medlabprojects/MCB_Motherboard/MCB_1-4_schematic.pdf

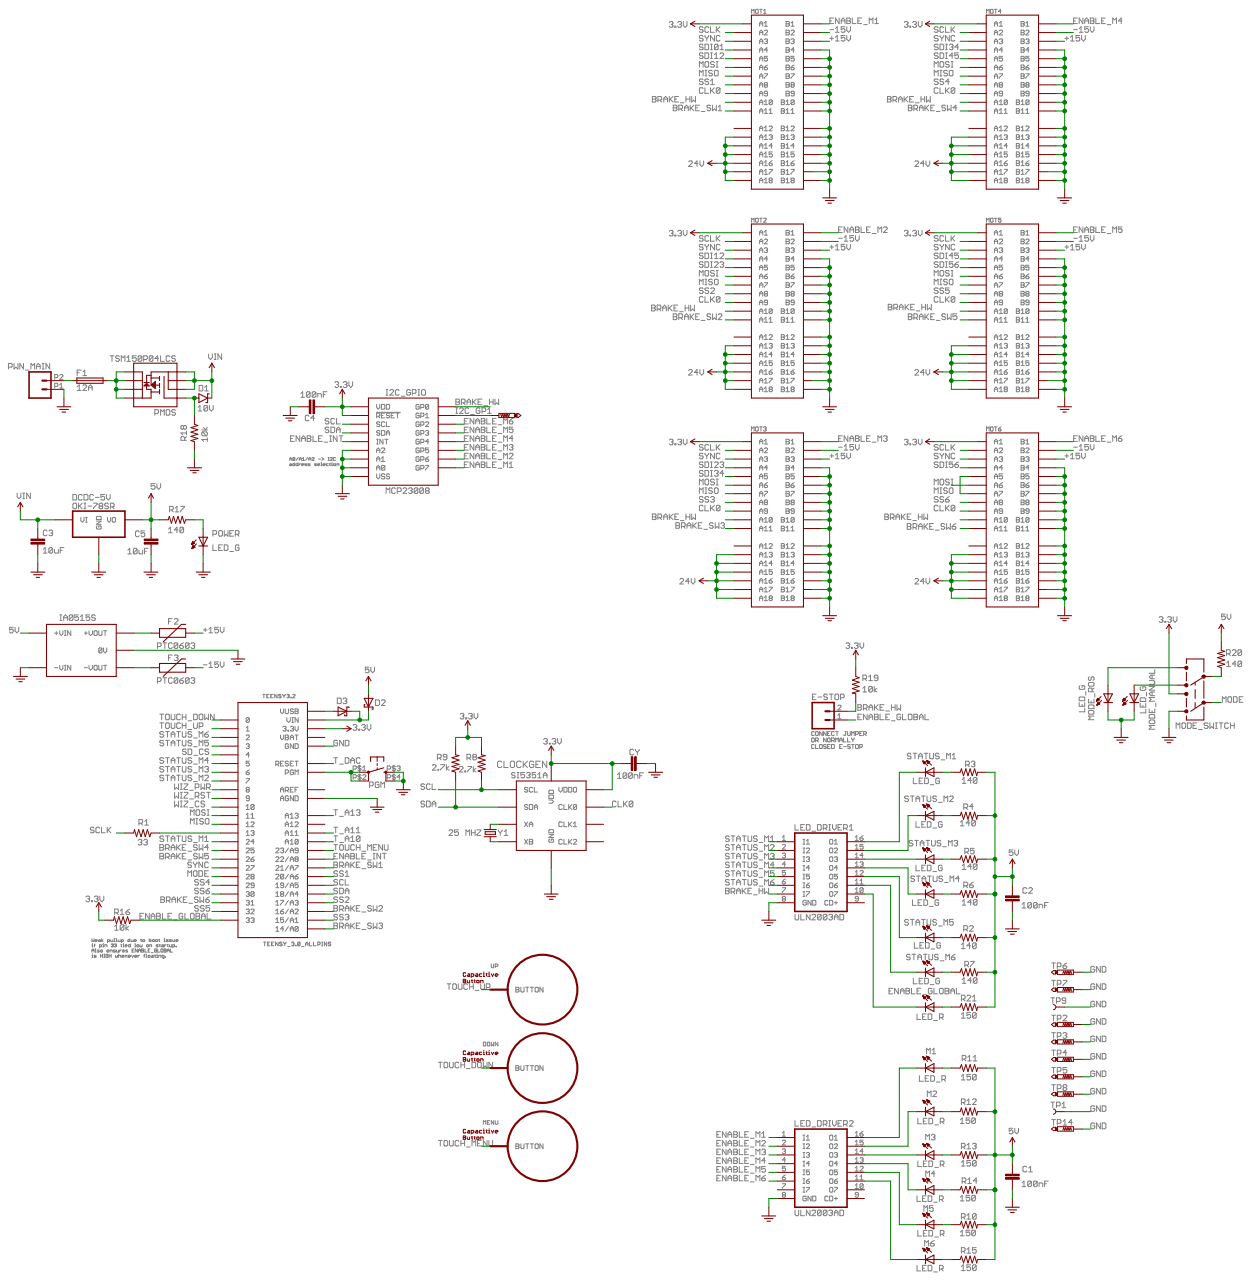
[picture p1: page 1]
