medlabprojects/MCB_Motherboard/Cannula_mother.brd

## EAGLE design Cannula_mother.brd (2018-11-03)

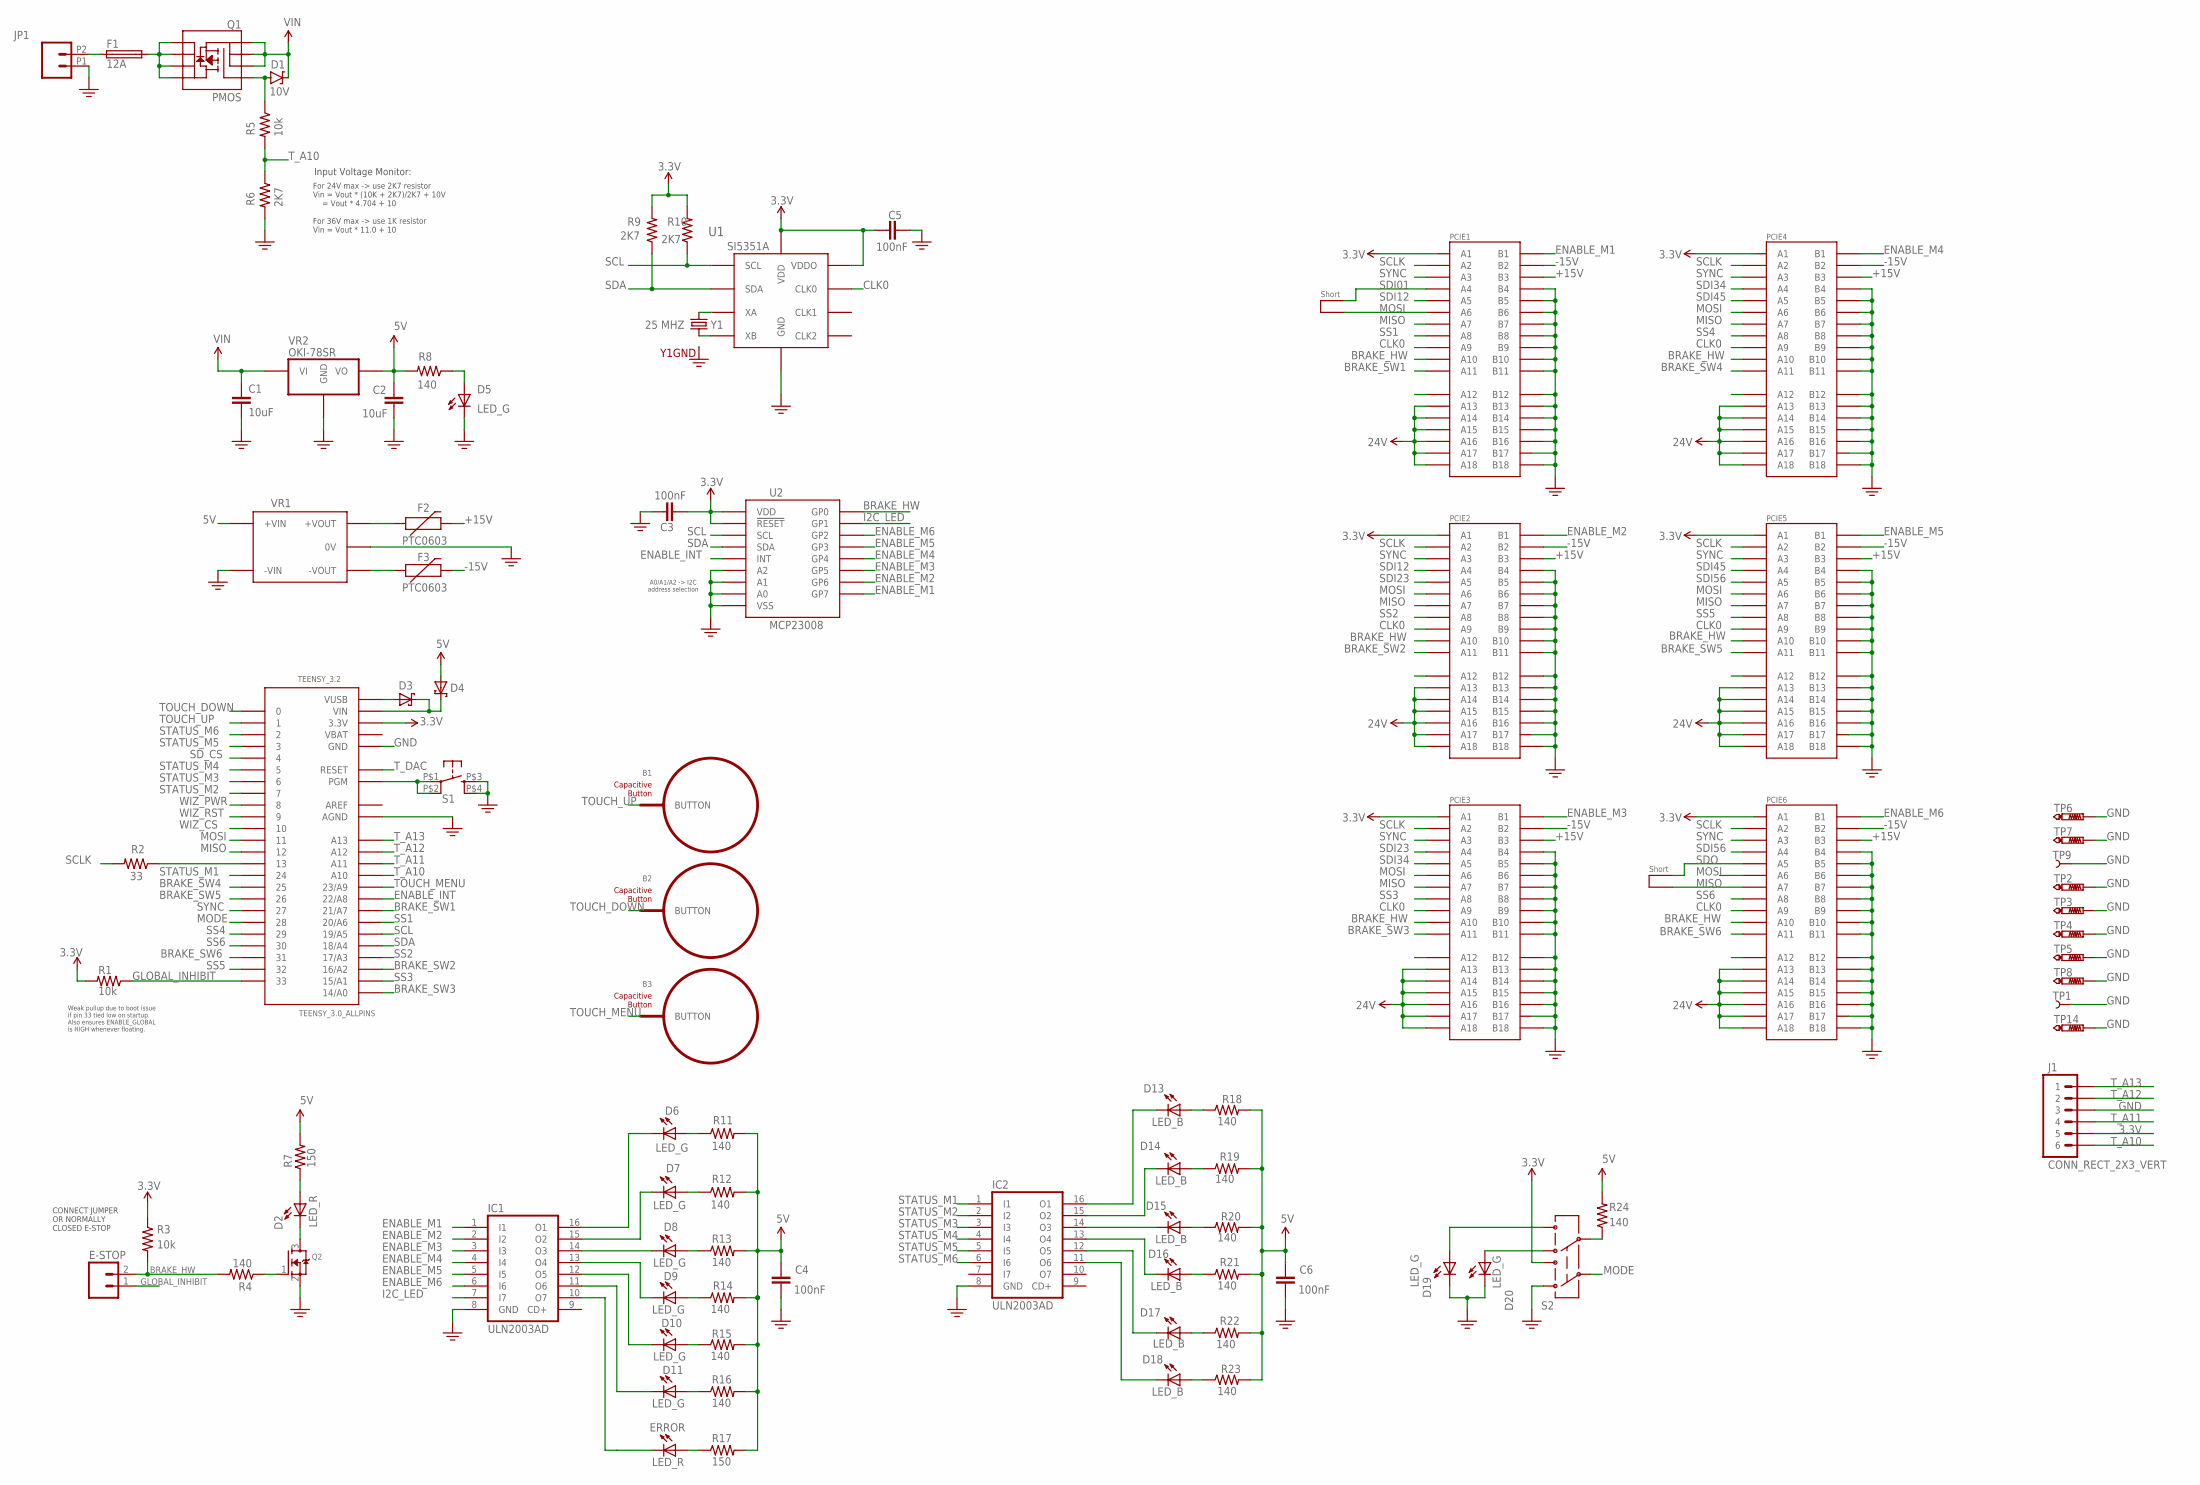
[picture p2: schematic Cannula_mother.sch, Motherboard]

Parts:
B1, B2: BUTTON_PASSIVE-8MM-ARROW; BUTTON_PASSIVE_8MM_UP
B3: BUTTON_PASSIVE-8MM-MENU; BUTTON_PASSIVE_8MM_MENU
C1, C2: 10uF; 1210
C3, C4, C5, C6: 100nF; 0603-CAP
D1: 10V; SOD-323
D2: LED_R; LED-0805
D3, D4: DIODE-POWERDI123; POWERDI123
D5, D6, D7, D8, D9, D10, D11, D19, D20: LED_G; LED-0805
D13, D14, D15, D16, D17, D18: LED_B; LED-0805
E-STOP: M02LOCK; 1X02_LOCK
ERROR: LED_R; LED-0805
F1: 12A; 1206
F2, F3: PTC0603; 0603
IC1, IC2: ULN2003AD; SO16
J1: CONN_RECT_2X3_VERT; 2X3
JP1: M026.35MM_SCREWTERM; 1X02_6.35_SCREWTERM
JP3, JP4: SHORT
PCIE1, PCIE2, PCIE3, PCIE4, PCIE5, PCIE6: PCIE-36-SKT
Q1: PMOS; SO08
Q2: MOSFET-NREFLOW; SOT23
R1, R3, R5: 10k; 0603-RES
R2: 33; 0603-RES
R4, R8, R11, R12, R13, R14, R15, R16, R18, R19, R20, R21, R22, R23, R24: 140; 0603-RES
R6, R9, R10: 2K7; 0603-RES
R7, R17: 150; 0603-RES
S1: SWITCH-TACT; LS38
S2: SWITCH-DPDT-SLIDER-SMD; JS202011SCQN
TEENSY_3.2: TEENSY_3.0_ALLPINS
TP1, TP9: TEST-POINT_5021
TP2, TP3, TP4, TP5, TP6, TP7, TP8, TP14: PTR1TP20R; TP20R
U1: SI5351A; MSOP10
U2: MCP23008; SSOP20
VR1: DCDC_IA_SERIES0515S; DCDC_IA_SERIES
VR2: OKI-78SR
Y1: 25 MHZ; CX3225SB

Connections:
3.3V: C3.1, C5.1, J1.5, PCIE1.A1, PCIE2.A1, PCIE3.A1, PCIE4.A1, PCIE5.A1, PCIE6.A1, R1.2, R3.1, R9.2, R10.2, S2.3, TEENSY_3.2.3.3V, TEENSY_3.2.3.3V1 (3.3V), TEENSY_3.2.3.3V2 (3.3V), U1.1 (VDD), U1.7 (VDDO), U2.6 (!RESET), U2.20 (VDD)
5V: C2.1, C4.1, C6.1, D4.P$2 (A), R7.2, R8.2, R11.2, R12.2, R13.2, R14.2, R15.2, R16.2, R17.2, R18.2, R19.2, R20.2, R21.2, R22.2, R23.2, R24.2, VR1.+VIN, VR2.P$3 (VO)
+15V: F2.2, PCIE1.B3, PCIE2.B3, PCIE3.B3, PCIE4.B3, PCIE5.B3, PCIE6.B3
-15V: F3.2, PCIE1.B2, PCIE2.B2, PCIE3.B2, PCIE4.B2, PCIE5.B2, PCIE6.B2
AREF: TEENSY_3.2.AREF
B: Q2.1 (G), R4.1
BRAKE_HW: E-STOP.2, PCIE1.A10, PCIE2.A10, PCIE3.A10, PCIE4.A10, PCIE5.A10, PCIE6.A10, R3.2, R4.2, U2.12 (GP0)
BRAKE_SW1: PCIE1.A11, TEENSY_3.2.21/A7
BRAKE_SW2: PCIE2.A11, TEENSY_3.2.16/A2
BRAKE_SW3: PCIE3.A11, TEENSY_3.2.14/A0
BRAKE_SW4: PCIE4.A11, TEENSY_3.2.25
BRAKE_SW5: PCIE5.A11, TEENSY_3.2.26
BRAKE_SW6: PCIE6.A11, TEENSY_3.2.31
C: D2.C, Q2.3 (D)
CLK0: PCIE1.A9, PCIE2.A9, PCIE3.A9, PCIE4.A9, PCIE5.A9, PCIE6.A9, U1.10 (CLK0)
ENABLE_INT: TEENSY_3.2.22/A8, U2.8 (INT)
ENABLE_M1: IC1.1 (I1), PCIE1.B1, U2.19 (GP7)
ENABLE_M2: IC1.2 (I2), PCIE2.B1, U2.18 (GP6)
ENABLE_M3: IC1.3 (I3), PCIE3.B1, U2.17 (GP5)
ENABLE_M4: IC1.4 (I4), PCIE4.B1, U2.16 (GP4)
ENABLE_M5: IC1.5 (I5), PCIE5.B1, U2.15 (GP3)
ENABLE_M6: IC1.6 (I6), PCIE6.B1, U2.14 (GP2)
GLOBAL_INHIBIT: E-STOP.1, R1.1, TEENSY_3.2.33
GND: C1.2, C2.2, C3.2, C4.2, C5.2, C6.2, D5.C, D19.C, D20.C, IC1.8 (GND), IC2.8 (GND), J1.3, JP1.P1 (1), PCIE1.B4, PCIE1.B5, PCIE1.B6, PCIE1.B7, PCIE1.B8, PCIE1.B9, PCIE1.B10, PCIE1.B11, PCIE1.B12, PCIE1.B13, PCIE1.B14, PCIE1.B15, PCIE1.B16, PCIE1.B17, PCIE1.B18, PCIE2.B4, PCIE2.B5, PCIE2.B6, PCIE2.B7, PCIE2.B8, PCIE2.B9, PCIE2.B10, PCIE2.B11, PCIE2.B12, PCIE2.B13, PCIE2.B14, PCIE2.B15, PCIE2.B16, PCIE2.B17, PCIE2.B18, PCIE3.B4, PCIE3.B5, PCIE3.B6, PCIE3.B7, PCIE3.B8, PCIE3.B9, PCIE3.B10, PCIE3.B11, PCIE3.B12, PCIE3.B13, PCIE3.B14, PCIE3.B15, PCIE3.B16, PCIE3.B17, PCIE3.B18, PCIE4.B4, PCIE4.B5, PCIE4.B6, PCIE4.B7, PCIE4.B8, PCIE4.B9, PCIE4.B10, PCIE4.B11, PCIE4.B12, PCIE4.B13, PCIE4.B14, PCIE4.B15, PCIE4.B16, PCIE4.B17, PCIE4.B18, PCIE5.B4, PCIE5.B5, PCIE5.B6, PCIE5.B7, PCIE5.B8, PCIE5.B9, PCIE5.B10, PCIE5.B11, PCIE5.B12, PCIE5.B13, PCIE5.B14, PCIE5.B15, PCIE5.B16, PCIE5.B17, PCIE5.B18, PCIE6.B4, PCIE6.B5, PCIE6.B6, PCIE6.B7, PCIE6.B8, PCIE6.B9, PCIE6.B10, PCIE6.B11, PCIE6.B12, PCIE6.B13, PCIE6.B14, PCIE6.B15, PCIE6.B16, PCIE6.B17, PCIE6.B18, Q2.2 (S), R6.2, S1.P$3 (3), S1.P$4 (4), S2.1, TEENSY_3.2.AGND, TEENSY_3.2.GND, TEENSY_3.2.GND1 (GND), TEENSY_3.2.GND2 (GND), TP1.P$1, TP2.TP, TP3.TP, TP4.TP, TP5.TP, TP6.TP, TP7.TP, TP8.TP, TP9.P$1, TP14.TP, U1.8 (GND), U2.3 (A2), U2.4 (A1), U2.5 (A0), U2.9 (VSS), VR1.0V, VR1.-VIN, VR2.P$2 (GND), Y1.GND@1 (GND), Y1.GND@2 (GND)
I2C_LED: IC1.7 (I7), U2.13 (GP1)
MISO: JP4.P$2, PCIE1.A7, PCIE2.A7, PCIE3.A7, PCIE4.A7, PCIE5.A7, PCIE6.A7, TEENSY_3.2.12
MODE: S2.2, TEENSY_3.2.28
MOSI: JP3.P$2, PCIE1.A6, PCIE2.A6, PCIE3.A6, PCIE4.A6, PCIE5.A6, PCIE6.A6, TEENSY_3.2.11
unnamed: F2.1, VR1.+VOUT
unnamed: F3.1, VR1.-VOUT
unnamed: D8.C, IC1.14 (O3)
unnamed: D2.A, R7.1
unnamed: D1.A, Q1.4 (G), R5.1
unnamed: D15.C, IC2.14 (O3)
unnamed: F1.P$2 (2), Q1.5 (D), Q1.6 (D), Q1.7 (D), Q1.8 (D)
unnamed: D5.A, R8.1
unnamed: R24.1, S2.5
unnamed: D20.A, S2.4
unnamed: D19.A, S2.6
unnamed: ERROR.A, R17.1
unnamed: F1.P$1 (1), JP1.P2 (2)
unnamed: D17.A, R22.1
unnamed: D13.A, R18.1
unnamed: D14.A, R19.1
unnamed: D15.A, R20.1
unnamed: D16.A, R21.1
unnamed: D18.A, R23.1
unnamed: ERROR.C, IC1.10 (O7)
unnamed: D10.A, R15.1
unnamed: D6.A, R11.1
unnamed: D7.A, R12.1
unnamed: D8.A, R13.1
unnamed: D9.A, R14.1
unnamed: D11.A, R16.1
unnamed: D13.C, IC2.16 (O1)
unnamed: D14.C, IC2.15 (O2)
unnamed: D16.C, IC2.13 (O4)
unnamed: D17.C, IC2.12 (O5)
unnamed: D18.C, IC2.11 (O6)
unnamed: D7.C, IC1.15 (O2)
unnamed: D9.C, IC1.13 (O4)
unnamed: D10.C, IC1.12 (O5)
unnamed: D11.C, IC1.11 (O6)
unnamed: D6.C, IC1.16 (O1)
unnamed: R2.1, TEENSY_3.2.13
PGM: S1.P$1 (1), S1.P$2 (2), TEENSY_3.2.PGM
SCL: R10.1, TEENSY_3.2.19/A5, U1.4 (SCL), U2.1 (SCL)
SCLK: PCIE1.A2, PCIE2.A2, PCIE3.A2, PCIE4.A2, PCIE5.A2, PCIE6.A2, R2.2
SDA: R9.1, TEENSY_3.2.18/A4, U1.5 (SDA), U2.2 (SDA)
SDI01: JP3.P$1, PCIE1.A4
SDI12: PCIE1.A5, PCIE2.A4
SDI23: PCIE2.A5, PCIE3.A4
SDI34: PCIE3.A5, PCIE4.A4
SDI45: PCIE4.A5, PCIE5.A4
SDI56: PCIE5.A5, PCIE6.A4
SDO: JP4.P$1, PCIE6.A5
SD_CS: TEENSY_3.2.4
SS1: PCIE1.A8, TEENSY_3.2.20/A6
SS2: PCIE2.A8, TEENSY_3.2.17/A3
SS3: PCIE3.A8, TEENSY_3.2.15/A1
SS4: PCIE4.A8, TEENSY_3.2.29
SS5: PCIE5.A8, TEENSY_3.2.32
SS6: PCIE6.A8, TEENSY_3.2.30
STATUS_M1: IC2.1 (I1), TEENSY_3.2.24
STATUS_M2: IC2.2 (I2), TEENSY_3.2.7
STATUS_M3: IC2.3 (I3), TEENSY_3.2.6
STATUS_M4: IC2.4 (I4), TEENSY_3.2.5
STATUS_M5: IC2.5 (I5), TEENSY_3.2.3
STATUS_M6: IC2.6 (I6), TEENSY_3.2.2
SYNC: PCIE1.A3, PCIE2.A3, PCIE3.A3, PCIE4.A3, PCIE5.A3, PCIE6.A3, TEENSY_3.2.27
TOUCH_DOWN: B2.BUTTON, TEENSY_3.2.0
TOUCH_MENU: B3.BUTTON, TEENSY_3.2.23/A9
TOUCH_UP: B1.BUTTON, TEENSY_3.2.1
T_A10: J1.6, R5.2, R6.1, TEENSY_3.2.A10
T_A11: J1.4, TEENSY_3.2.A11
T_A12: J1.2, TEENSY_3.2.A12
T_A13: J1.1, TEENSY_3.2.A13
T_DAC: TEENSY_3.2.RESET
T_VIN: D3.P$1 (C), D4.P$1 (C), TEENSY_3.2.VIN
VBAT: TEENSY_3.2.VBAT
VIN: C1.1, D1.C, PCIE1.A13, PCIE1.A14, PCIE1.A15, PCIE1.A16, PCIE1.A17, PCIE1.A18, PCIE2.A13, PCIE2.A14, PCIE2.A15, PCIE2.A16, PCIE2.A17, PCIE2.A18, PCIE3.A13, PCIE3.A14, PCIE3.A15, PCIE3.A16, PCIE3.A17, PCIE3.A18, PCIE4.A13, PCIE4.A14, PCIE4.A15, PCIE4.A16, PCIE4.A17, PCIE4.A18, PCIE5.A13, PCIE5.A14, PCIE5.A15, PCIE5.A16, PCIE5.A17, PCIE5.A18, PCIE6.A13, PCIE6.A14, PCIE6.A15, PCIE6.A16, PCIE6.A17, PCIE6.A18, Q1.1 (S), Q1.2 (S), Q1.3 (S), VR2.P$1 (VI)
VUSB: D3.P$2 (A), TEENSY_3.2.VUSB
WIZ_CS: TEENSY_3.2.10
WIZ_PWR: TEENSY_3.2.8
WIZ_RST: TEENSY_3.2.9
XA: U1.2 (XA), Y1.HOT2 (2)
XB: U1.3 (XB), Y1.HOT1 (1)

Notes on the sheet:
CONNECT JUMPER OR NORMALLY CLOSED E-STOP
A0/A1/A2 -> I2C address selection
Weak pullup due to boot issue if pin 33 tied low on startup. Also ensures ENABLE_GLOBAL is HIGH whenever floating.
Input Voltage Monitor:
For 24V max -> use 2K7 resistor Vin = Vout * (10K + 2K7)/2K7 + 10V = Vout * 4.704 + 10 For 36V max -> use 1K resistor Vin = Vout * 11.0 + 10

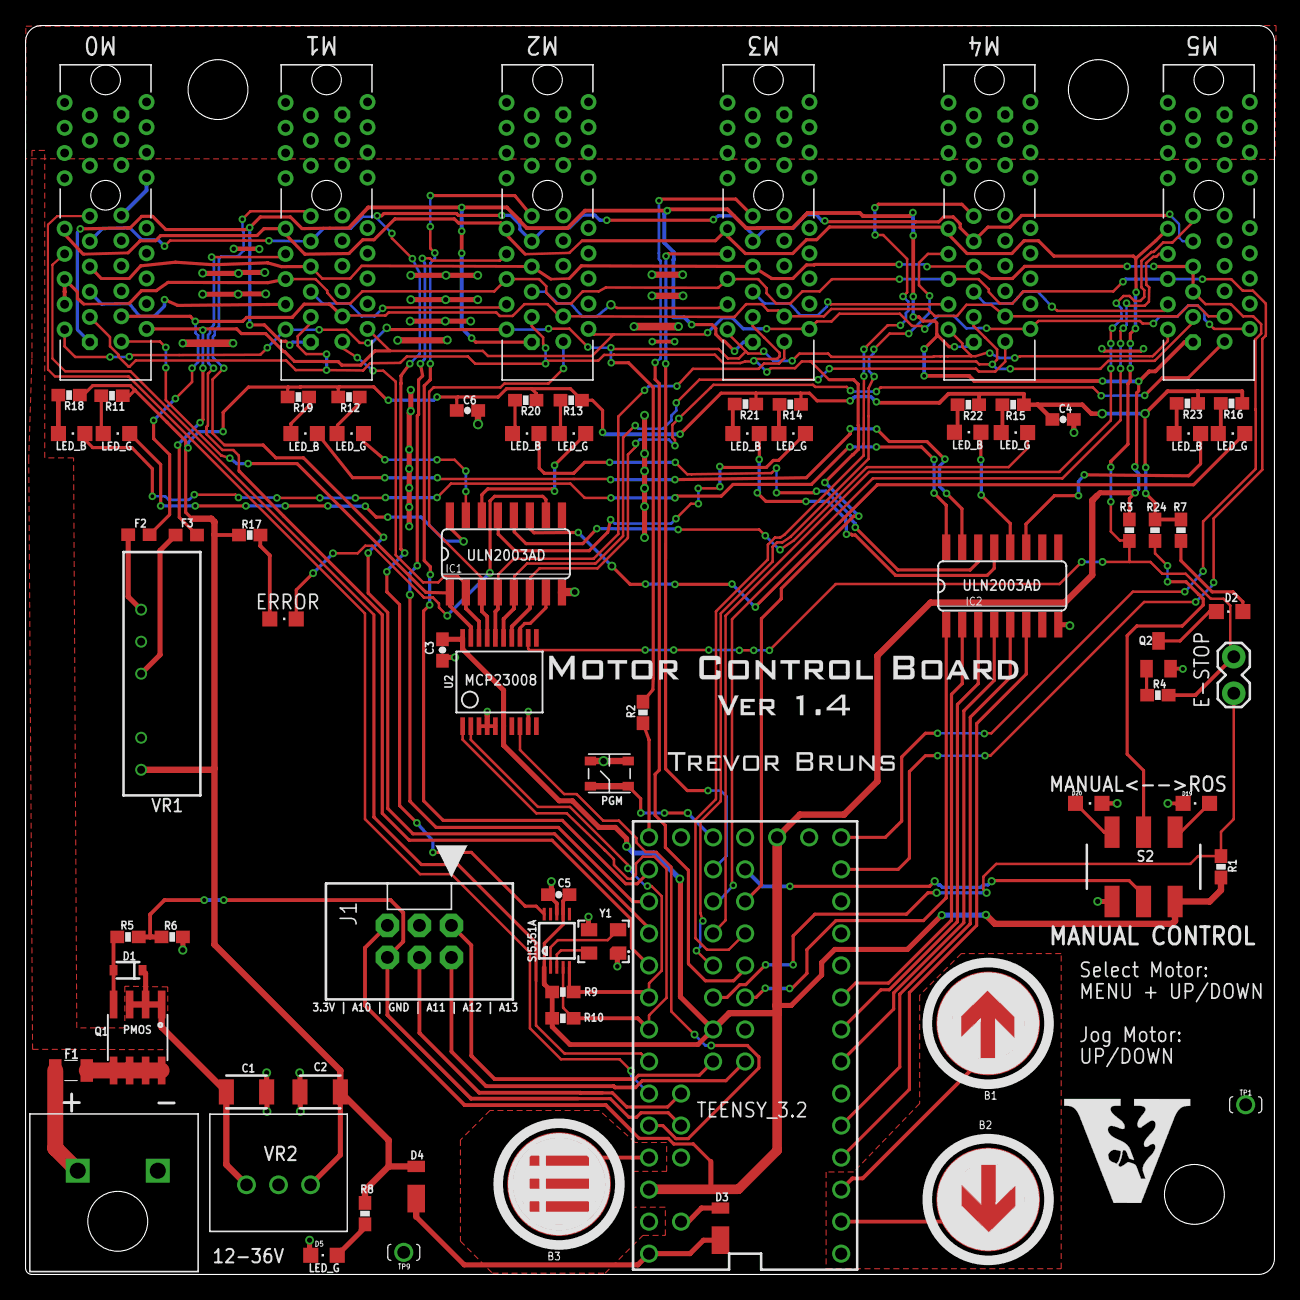
[picture p3: board Cannula_mother.brd from above]

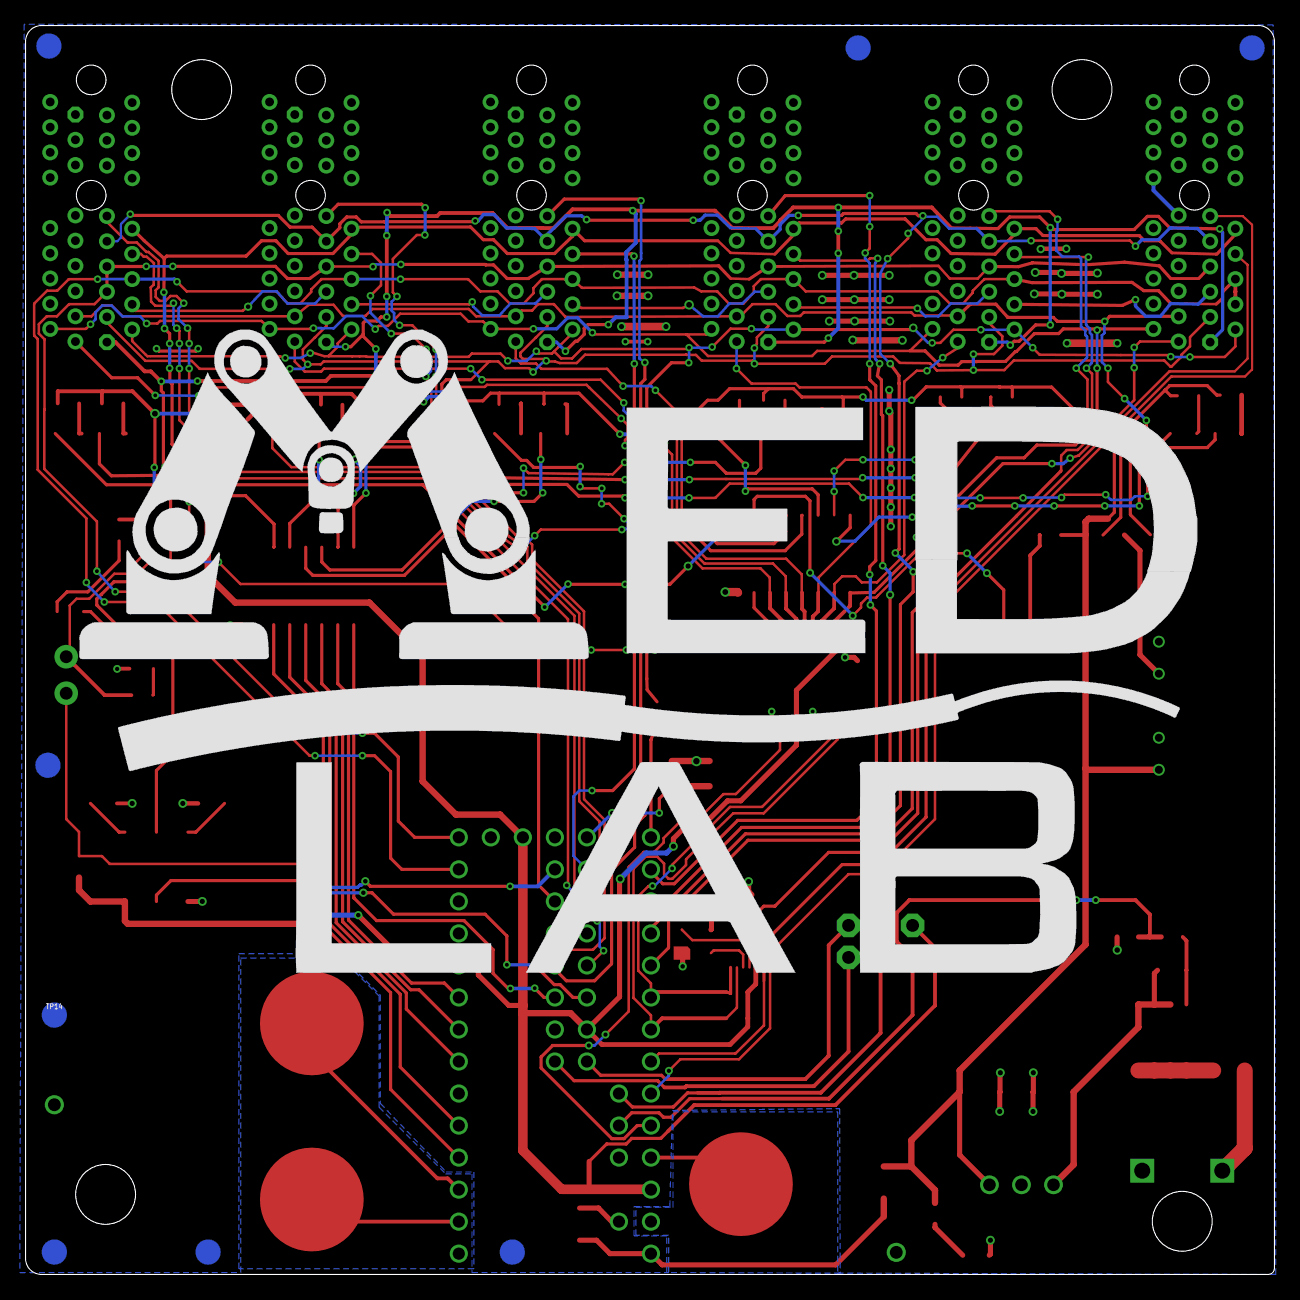
[picture p4: board Cannula_mother.brd from below]

Board: 2 copper layers, 99.1 x 99.1 mm, 96 parts (9 on the bottom side), 100 nets.

Other parts of the board:
24V: SPACER
U$1, U$3, U$4: SPACER
U$2: LOGO_MOTOR_CONTROL_1.4
U$6: LOGO_MEDLAB_3X2
U$8: LOGO_V_OAK
