medlabprojects/MCB_Motherboard/(commit log)

2018-11-02 1.4- as ordered
    [Cannula_mother.brd, Cannula_mother.sch, Cannula_mother_BOM.csv]
2018-11-03 Changes almost finished
    [Cannula_mother.brd, Cannula_mother.sch]
2018-11-03 Finished edits
    [Cannula_mother.brd, Cannula_mother.sch]
2018-11-04 Created gerbers
