medlabprojects/MCB_Motherboard/(notices)

Notices in the files:
parts and their libraries:
Cannula_1_0: License : http://creativecommons.org/licenses/by-sa/3.1/ (Creative Commons 3.1)
SparkFun-Capacitors: Licensing: Creative Commons ShareAlike 4.0 International - https://creativecommons.org/licenses/by-sa/4.0
